MaltWhiskey/Adaline/README.md

# Adaline
Widrow Hoff - Adaptive Linear Neuron
