MaltWhiskey/Adaline/Documents/Design/Oled Lock.stl

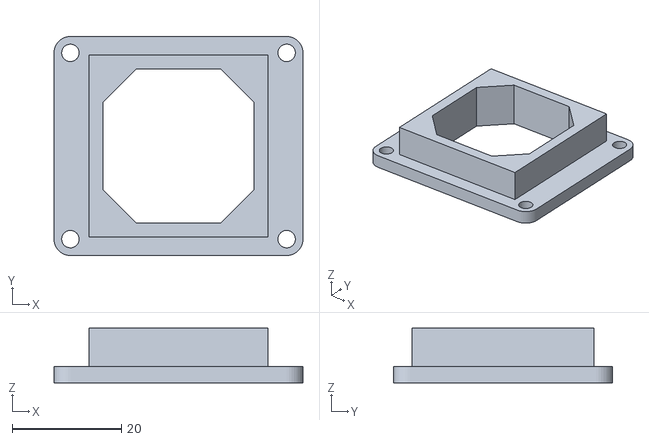
[picture p15: CAD file, 2026-02-04]
Documents/Design/Oled Lock.stl
45.7 x 40.2 x 10.0
