MaltWhiskey/Adaline/Documents/Source (Origin)/Adaline Top panel.dxf

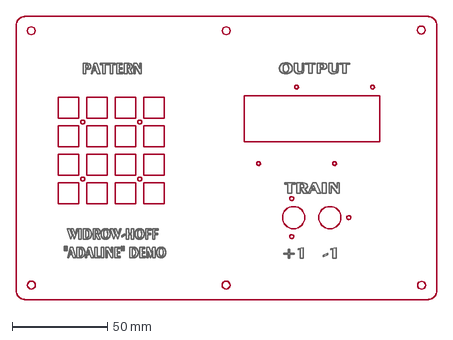
[picture p16: CAD file, 2026-02-04]
Documents/Source (Origin)/Adaline Top panel.dxf
221.5 x 149.0 mm
