MaltWhiskey/Adaline/Documents/Design/Adeline.stl

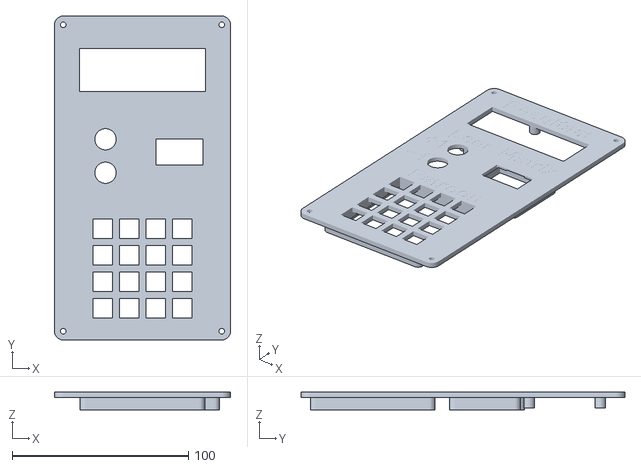
[picture p17: CAD file, 2026-02-04]
Documents/Design/Adeline.stl
100.0 x 184.0 x 10.0
