MaltWhiskey/Adaline/Documents/Design/Keypad Lock.stl

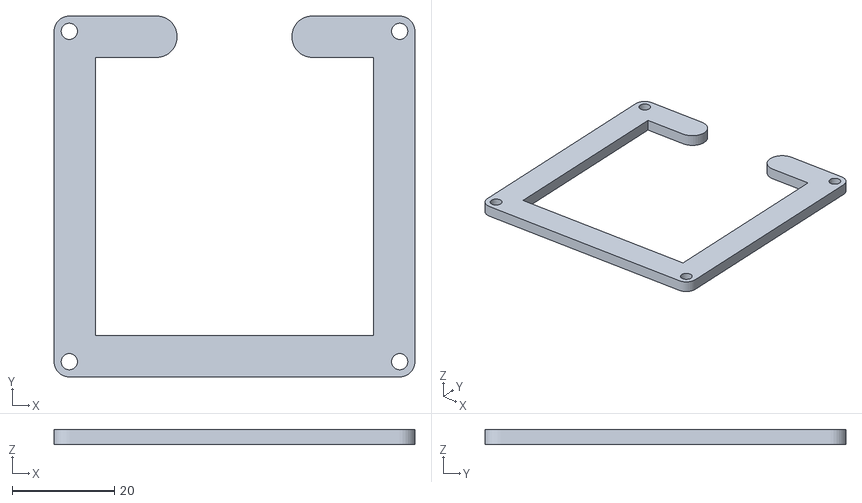
[picture p18: CAD file, 2026-02-04]
Documents/Design/Keypad Lock.stl
70.7 x 70.7 x 3.00
