MaltWhiskey/Adaline/Documents/Design/Box.stl

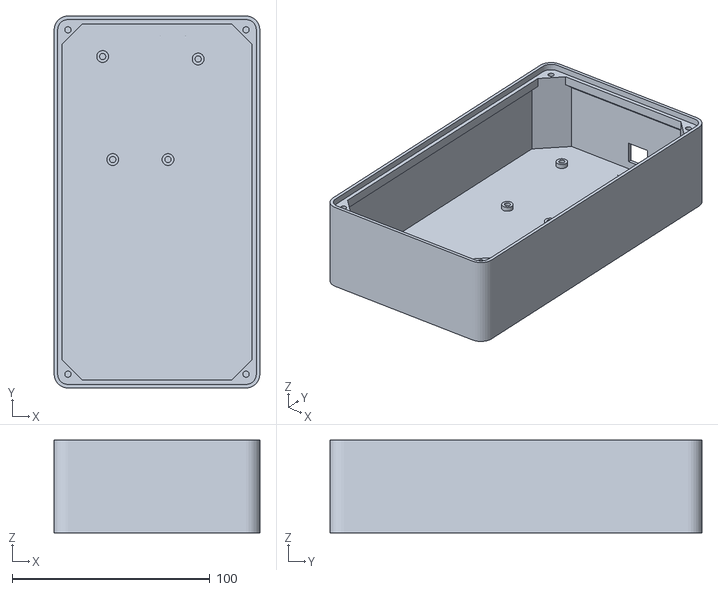
[picture p19: CAD file, 2026-02-04]
Documents/Design/Box.stl
104.0 x 188.0 x 47.0
